ICST-Technion/W23_Drummer/README.md

# Drummer
## Bring the beat to life!
Presentation1new

## Project Description: 
### An interactive drum that can be used as a tool for musicians to create inspired and full sounding music.
**Features:**
* Calibration Mode – sets the hit sound levels for use
* Metronome Mode – produces a beat at a given frequency
* Playback Mode – records and replays the beat created by the user
* Looper Mode – repeats the beat created by the user in a loop, allowing the user to build on the beat
* Interactive Mode – produces a bar of beats to follow the user’s bar and to continue the rhythm

## List of Content:
### Drummer
Code for the ESP32, which controls the microphone and solenoids according to the mode instructions set.

### Application
Files that are relevant to the application which acts as the user interface to control the modes.

### Model
Notebook for creating the neural network for interactive mode.

### Unit Tests
Basic test code for hardware accessories such as the microphone, pedal, and solenoids. These tests can be used in the event of a malfunction in order to test the accessories.

### Documentation
PDF files for the documentation of the project.

## System Diagram:
System Diagram

## Wiring Diagram:
Wiring Diagram

## User Interface – Application:


## Libraries Used:
* For the ESP code - BLE libraries, TFLite and TFLite Micro
* For the Appliaction - flutter_blue
