ICST-Technion/W23_Drummer/Drummer/src/NeuralNetwork.cpp

#include "NeuralNetwork.h"
#include "model_data.h"
#include "tensorflow/lite/micro/all_ops_resolver.h"
#include "tensorflow/lite/micro/micro_error_reporter.h"
#include "tensorflow/lite/micro/micro_interpreter.h"
#include "tensorflow/lite/schema/schema_generated.h"
#include "tensorflow/lite/version.h"
#include <Arduino.h>

const int kArenaSize = 50000; //20000;

NeuralNetwork::NeuralNetwork()
{
    error_reporter = new tflite::MicroErrorReporter();

    model = tflite::GetModel(model_data_tflite);
    if (model->version() != TFLITE_SCHEMA_VERSION)
    {
        TF_LITE_REPORT_ERROR(error_reporter, "Model provided is schema version %d not equal to supported version %d.",
                             model->version(), TFLITE_SCHEMA_VERSION);
        return;
    }
    // This pulls in the operators implementations we need
    resolver = new tflite::MicroMutableOpResolver<10>();
    resolver->AddFullyConnected();
    resolver->AddMul();
    resolver->AddAdd();
    resolver->AddLogistic();
    resolver->AddReshape();
    resolver->AddQuantize();
    resolver->AddDequantize();

    tensor_arena = (uint8_t *)malloc(kArenaSize);
    if (!tensor_arena)
    {
        TF_LITE_REPORT_ERROR(error_reporter, "Could not allocate arena");
        return;
    }

    // Build an interpreter to run the model with.
    interpreter = new tflite::MicroInterpreter(
        model, *resolver, tensor_arena, kArenaSize, error_reporter);

    // Allocate memory from the tensor_arena for the model's tensors.
    TfLiteStatus allocate_status = interpreter->AllocateTensors();
    if (allocate_status != kTfLiteOk)
    {
        TF_LITE_REPORT_ERROR(error_reporter, "AllocateTensors() failed");
        return;
    }

    size_t used_bytes = interpreter->arena_used_bytes();
    TF_LITE_REPORT_ERROR(error_reporter, "Used bytes %d\n", used_bytes);

    // Obtain pointers to the model's input and output tensors.
    input = interpreter->input(0);
    output = interpreter->output(0);
}

int *NeuralNetwork::getInputBuffer()
{
    return input->data.i32;
}

int NeuralNetwork::predict()
{
    int max_index = 0;
    int p = 0;
    float max = 0.0;
    interpreter->Invoke();
    for(int i=0; i<4; i++){
        Serial.println(output->data.f[i]);
        if(output->data.f[i] > max){
            max = output->data.f[i];
            max_index = i;
        }
    }
    p = max_index + 1;
    p = (rand() % 4) + 1;
    return p;
}
