ICST-Technion/W23_Drummer/Drummer/src/NeuralNetwork.h

#ifndef __NeuralNetwork__
#define __NeuralNetwork__

#include <stdint.h>

namespace tflite
{
    template <unsigned int tOpCount>
    class MicroMutableOpResolver;
    class ErrorReporter;
    class Model;
    class MicroInterpreter;
} // namespace tflite

struct TfLiteTensor;

class NeuralNetwork
{
private:
    tflite::MicroMutableOpResolver<10> *resolver;
    tflite::ErrorReporter *error_reporter;
    const tflite::Model *model;
    tflite::MicroInterpreter *interpreter;
    TfLiteTensor *input;
    TfLiteTensor *output;
    uint8_t *tensor_arena;

public:
    int *getInputBuffer();
    NeuralNetwork();
    int predict();
};

#endif
